georg4242/masterplatine_robosax2018/SC images/board.png

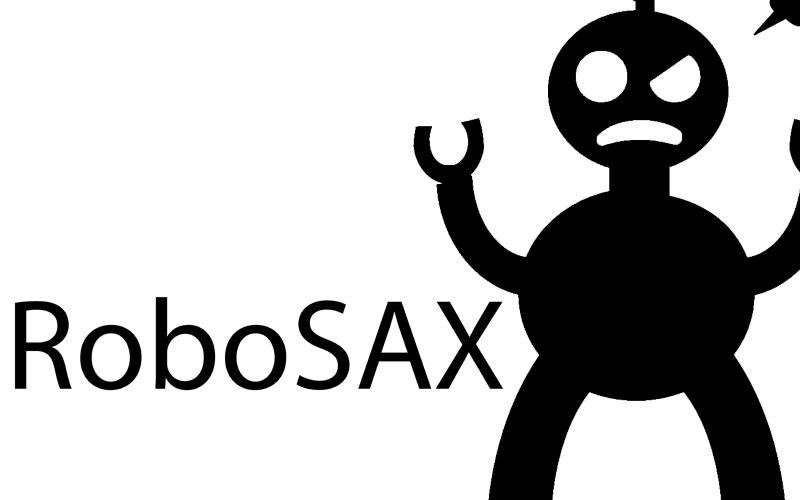
SC images/board.png
