georg4242/masterplatine_robosax2018/masterbox.kicad_pcb

## KiCad design masterbox.kicad_pcb (2018-01-08)

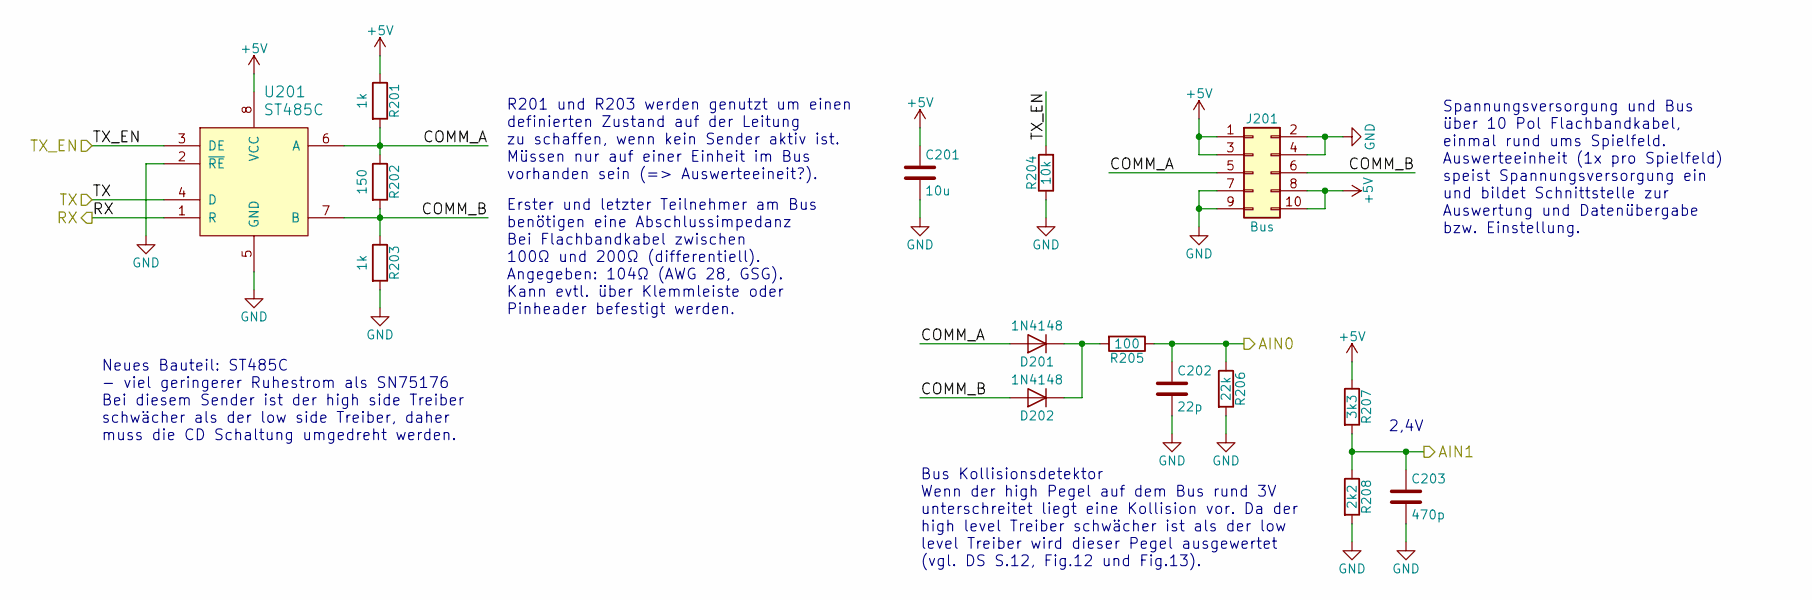
[picture p2: schematic Bus.sch]

Parts:
C201: 10u; C_0805
C202: 22p; C_0805
C203: 470p; C_0805
D201, D202: 1N4148; D_SOD-123
J201: Bus; Pin_Header_Straight_2x05
R201, R203: 1k; R_0805
R202: 150; R_Axial_DIN0207_L6.3mm_D2.5mm_P7.62mm_Horizontal
R204: 10k; R_0805
R205: 100; R_0805
R206: 22k; R_0805
R207: 3k3; R_0805
R208: 2k2; R_0805
U201: ST485C; SOIC-8_3.9x4.9mm_Pitch1.27mm

Connections:
+5V: C201.1, J201.1, J201.3, J201.8, J201.10, R201.1, R207.1, U201.8 (VCC); also elsewhere on the board
/Bus/AIN0: C202.1, R205.1, R206.1; also elsewhere on the board
/Bus/AIN1: C203.1, R207.2, R208.1; also elsewhere on the board
/Bus/COMM_A: D201.2 (A), J201.5, R201.2, R202.1, U201.6 (A)
/Bus/COMM_B: D202.2 (A), J201.6, R202.2, R203.1, U201.7 (B)
/Bus/RX: U201.1 (R); also elsewhere on the board
/Bus/TX: U201.4 (D); also elsewhere on the board
/Bus/TX_EN: R204.2, U201.3 (DE); also elsewhere on the board
GND: C201.2, C202.2, C203.2, J201.2, J201.4, J201.7, J201.9, R203.2, R204.1, R206.2, R208.2, U201.2 (~RE), U201.5 (GND); also elsewhere on the board
unnamed: D201.1 (K), D202.1 (K), R205.2

Notes on the sheet:
Bus Kollisionsdetektor Wenn der high Pegel auf dem Bus rund 3V unterschreitet liegt eine Kollision vor. Da der high level Treiber schwächer ist als der low level Treiber wird dieser Pegel ausgewertet (vgl. DS S.12, Fig.12 und Fig.13).
2,4V
Erster und letzter Teilnehmer am Bus benötigen eine Abschlussimpedanz Bei Flachbandkabel zwischen 100Ω und 200Ω (differentiell). Angegeben: 104Ω (AWG 28, GSG). Kann evtl. über Klemmleiste oder Pinheader befestigt werden.
R201 und R203 werden genutzt um einen definierten Zustand auf der Leitung zu schaffen, wenn kein Sender aktiv ist. Müssen nur auf einer Einheit im Bus vorhanden sein (=> Auswerteeineit?).
Neues Bauteil: ST485C - viel geringerer Ruhestrom als SN75176 Bei diesem Sender ist der high side Treiber schwächer als der low side Treiber, daher muss die CD Schaltung umgedreht werden.
Spannungsversorgung und Bus über 10 Pol Flachbandkabel, einmal rund ums Spielfeld. Auswerteeinheit (1x pro Spielfeld) speist Spannungsversorgung ein und bildet Schnittstelle zur Auswertung und Datenübergabe bzw. Einstellung.

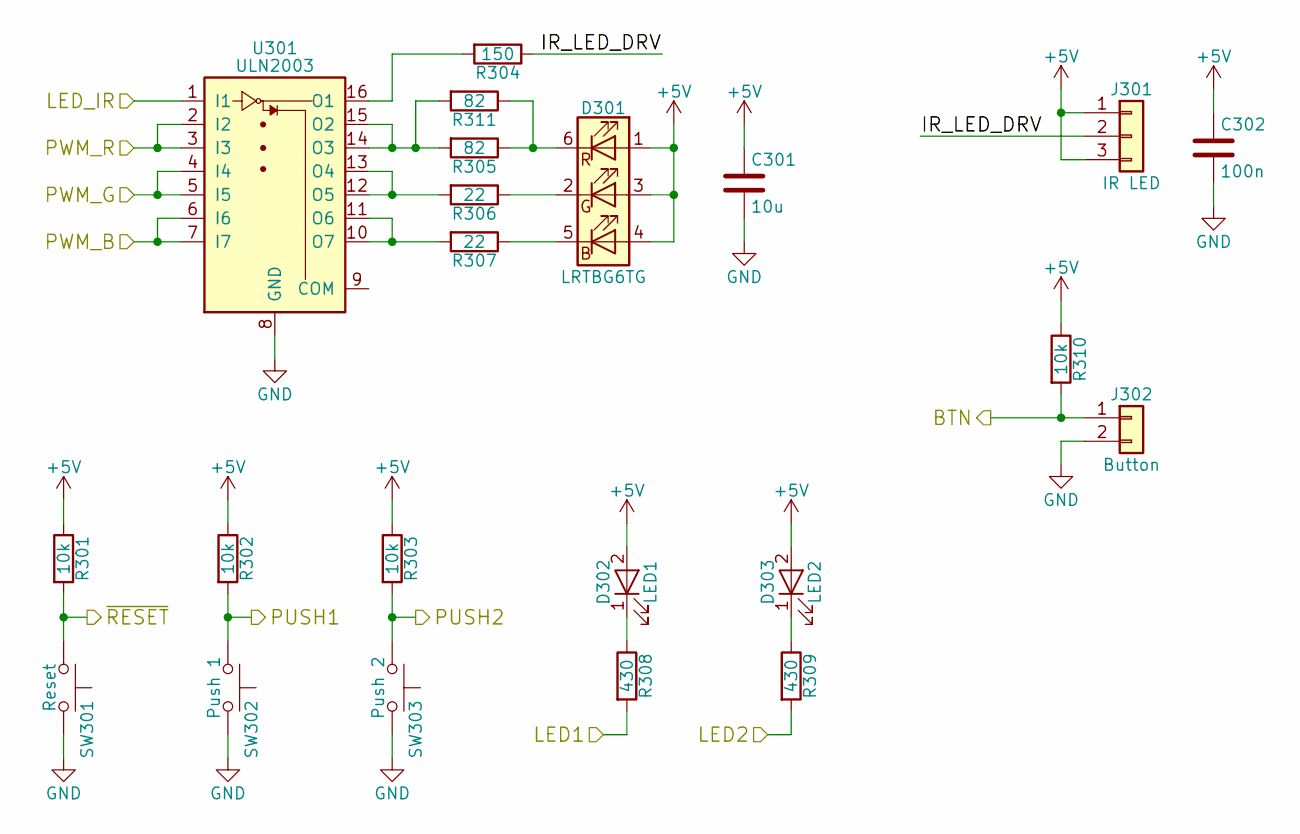
[picture p3: schematic Interface.sch]

Parts:
C301: 10u; C_0805
C302: 100n; C_0805
D301: LRTBG6TG; LED-6-BIG
D302: LED1; LED_0805
D303: LED2; LED_0805
J301: IR LED; Pin_Header_Straight_1x03
J302: Button; Pin_Header_Straight_1x02
R301, R302, R303, R310: 10k; R_0805
R304: 150; R_0805
R305, R311: 82; R_0805
R306, R307: 22; R_0805
R308, R309: 430; R_0805
SW301: Reset; SW_PUSH_6mm_h5mm
SW302: Push 1; SW_PUSH_6mm_h5mm
SW303: Push 2; SW_PUSH_6mm_h5mm
U301: ULN2003; SOIC-16_3.9x9.9mm_Pitch1.27mm

Connections:
+5V: C301.1, C302.1, D301.1 (RA), D301.3 (GA), D301.4 (BA), D302.2 (A), D303.2 (A), J301.1, J301.3, R301.1, R302.1, R303.1, R310.1; also elsewhere on the board
/Controller/BTN: J302.1, R310.2; also elsewhere on the board
/Controller/LED1: R308.2; also elsewhere on the board
/Controller/LED2: R309.2; also elsewhere on the board
/Controller/LED_IR: U301.1 (I1); also elsewhere on the board
/Controller/PUSH1: R302.2, SW302.1; also elsewhere on the board
/Controller/PUSH2: R303.2, SW303.1; also elsewhere on the board
/Controller/PWM_B: U301.6 (I6), U301.7 (I7); also elsewhere on the board
/Controller/PWM_G: U301.4 (I4), U301.5 (I5); also elsewhere on the board
/Controller/PWM_R: U301.2 (I2), U301.3 (I3); also elsewhere on the board
/Controller/~RESET: R301.2, SW301.1; also elsewhere on the board
/Interface/IR_LED_DRV: J301.2, R304.1
GND: C301.2, C302.2, J302.2, SW301.2, SW302.2, SW303.2, U301.8 (GND); also elsewhere on the board
unnamed: D301.2 (GK), R306.1
unnamed: D301.5 (BK), R307.1
unnamed: D301.6 (RK), R305.1, R311.1
unnamed: D302.1 (K), R308.1
unnamed: D303.1 (K), R309.1
unnamed: R304.2, U301.16 (O1)
unnamed: R305.2, R311.2, U301.14 (O3), U301.15 (O2)
unnamed: R306.2, U301.12 (O5), U301.13 (O4)
unnamed: R307.2, U301.10 (O7), U301.11 (O6)

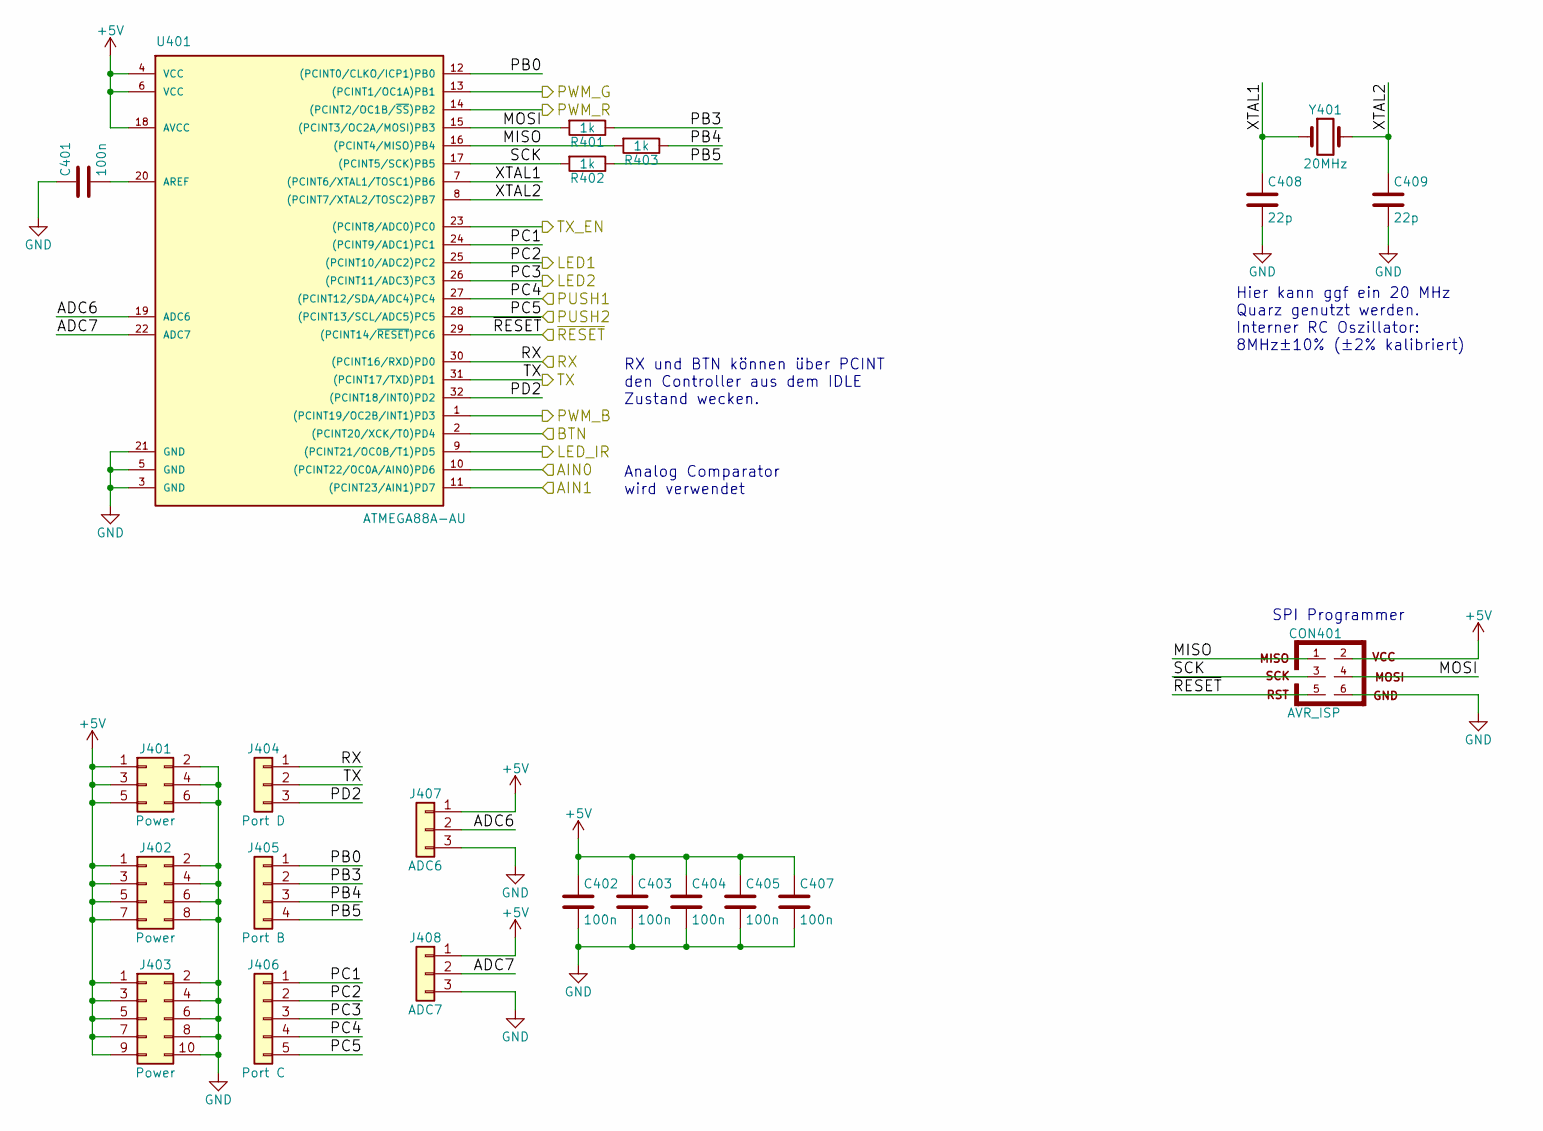
[picture p4: schematic Controller.sch]

Parts:
C401, C402, C403, C404, C405, C407: 100n; C_0805
C408, C409: 22p; C_0805
CON401: AVR_ISP; Pin_Header_Straight_2x03
J401: Power; Socket_Strip_Straight_2x03
J402: Power; Socket_Strip_Straight_2x04
J403: Power; Socket_Strip_Straight_2x05
J404: Port D; Socket_Strip_Straight_1x03
J405: Port B; Socket_Strip_Straight_1x04
J406: Port C; Socket_Strip_Straight_1x05
J407: ADC6; Socket_Strip_Straight_1x03
J408: ADC7; Socket_Strip_Straight_1x03
R401, R402, R403: 1k; R_0805
U401: ATMEGA88A-AU; TQFP-32_7x7mm_Pitch0.8mm
Y401: 20MHz; Crystal_HC49-SD_SMD

Connections:
+5V: C402.1, C403.1, C404.1, C405.1, C407.1, CON401.2, J401.1, J401.3, J401.5, J402.1, J402.3, J402.5, J402.7, J403.1, J403.3, J403.5, J403.7, J403.9, J407.1, J408.1, U401.4 (VCC), U401.6 (VCC), U401.18 (AVCC); also elsewhere on the board
/Bus/AIN0: U401.10 ((PCINT22/OC0A/AIN0)PD6); also elsewhere on the board
/Bus/AIN1: U401.11 ((PCINT23/AIN1)PD7); also elsewhere on the board
/Bus/RX: J404.1, U401.30 ((PCINT16/RXD)PD0); also elsewhere on the board
/Bus/TX: J404.2, U401.31 ((PCINT17/TXD)PD1); also elsewhere on the board
/Bus/TX_EN: U401.23 ((PCINT8/ADC0)PC0); also elsewhere on the board
/Controller/ADC6: J407.2, U401.19 (ADC6)
/Controller/ADC7: J408.2, U401.22 (ADC7)
/Controller/BTN: U401.2 ((PCINT20/XCK/T0)PD4); also elsewhere on the board
/Controller/LED1: J406.2, U401.25 ((PCINT10/ADC2)PC2); also elsewhere on the board
/Controller/LED2: J406.3, U401.26 ((PCINT11/ADC3)PC3); also elsewhere on the board
/Controller/LED_IR: U401.9 ((PCINT21/OC0B/T1)PD5); also elsewhere on the board
/Controller/MISO: CON401.1, R403.2, U401.16 ((PCINT4/MISO)PB4)
/Controller/MOSI: CON401.4, R401.2, U401.15 ((PCINT3/OC2A/MOSI)PB3)
/Controller/PB0: J405.1, U401.12 ((PCINT0/CLKO/ICP1)PB0)
/Controller/PB3: J405.2, R401.1
/Controller/PB4: J405.3, R403.1
/Controller/PB5: J405.4, R402.1
/Controller/PC1: J406.1, U401.24 ((PCINT9/ADC1)PC1)
/Controller/PD2: J404.3, U401.32 ((PCINT18/INT0)PD2)
/Controller/PUSH1: J406.4, U401.27 ((PCINT12/SDA/ADC4)PC4); also elsewhere on the board
/Controller/PUSH2: J406.5, U401.28 ((PCINT13/SCL/ADC5)PC5); also elsewhere on the board
/Controller/PWM_B: U401.1 ((PCINT19/OC2B/INT1)PD3); also elsewhere on the board
/Controller/PWM_G: U401.13 ((PCINT1/OC1A)PB1); also elsewhere on the board
/Controller/PWM_R: U401.14 ((PCINT2/OC1B/~SS~)PB2); also elsewhere on the board
/Controller/SCK: CON401.3, R402.2, U401.17 ((PCINT5/SCK)PB5)
/Controller/XTAL1: C408.1, U401.7 ((PCINT6/XTAL1/TOSC1)PB6), Y401.1
/Controller/XTAL2: C409.1, U401.8 ((PCINT7/XTAL2/TOSC2)PB7), Y401.2
/Controller/~RESET: CON401.5, U401.29 ((PCINT14/~RESET~)PC6); also elsewhere on the board
GND: C401.1, C402.2, C403.2, C404.2, C405.2, C407.2, C408.2, C409.2, CON401.6, J401.2, J401.4, J401.6, J402.2, J402.4, J402.6, J402.8, J403.2, J403.4, J403.6, J403.8, J403.10, J407.3, J408.3, U401.3 (GND), U401.5 (GND), U401.21 (GND); also elsewhere on the board
unnamed: C401.2, U401.20 (AREF)

Notes on the sheet:
Hier kann ggf ein 20 MHz Quarz genutzt werden. Interner RC Oszillator: 8MHz±10% (±2% kalibriert)
RX und BTN können über PCINT den Controller aus dem IDLE Zustand wecken.
SPI Programmer
Analog Comparator wird verwendet

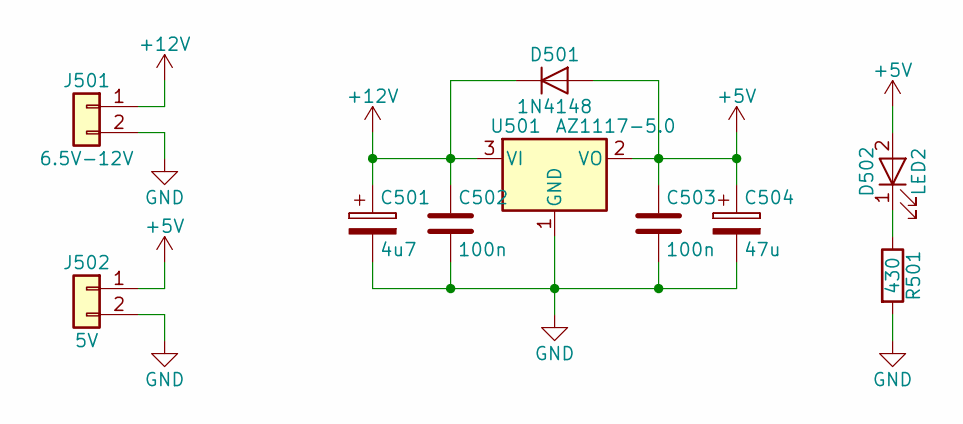
[picture p5: schematic Supply.sch]

Parts:
C501: 4u7; CP_Radial_D5.0mm_P2.00mm
C502, C503: 100n; C_0805
C504: 47u; CP_Radial_D6.3mm_P2.50mm
D501: 1N4148; D_SOD-123
D502: LED2; LED_0805
J501: 6.5V-12V; TerminalBlock_Pheonix_MKDS1.5-2pol
J502: 5V; TerminalBlock_Pheonix_MKDS1.5-2pol
R501: 430; R_0805
U501: AZ1117-5.0; SOT-223-3Lead_TabPin2

Connections:
+5V: C503.1, C504.1, D501.2 (A), D502.2 (A), J502.1, U501.2 (VO); also elsewhere on the board
+12V: C501.1, C502.1, D501.1 (K), J501.1, U501.3 (VI)
GND: C501.2, C502.2, C503.2, C504.2, J501.2, J502.2, R501.2, U501.1 (GND); also elsewhere on the board
unnamed: D502.1 (K), R501.1

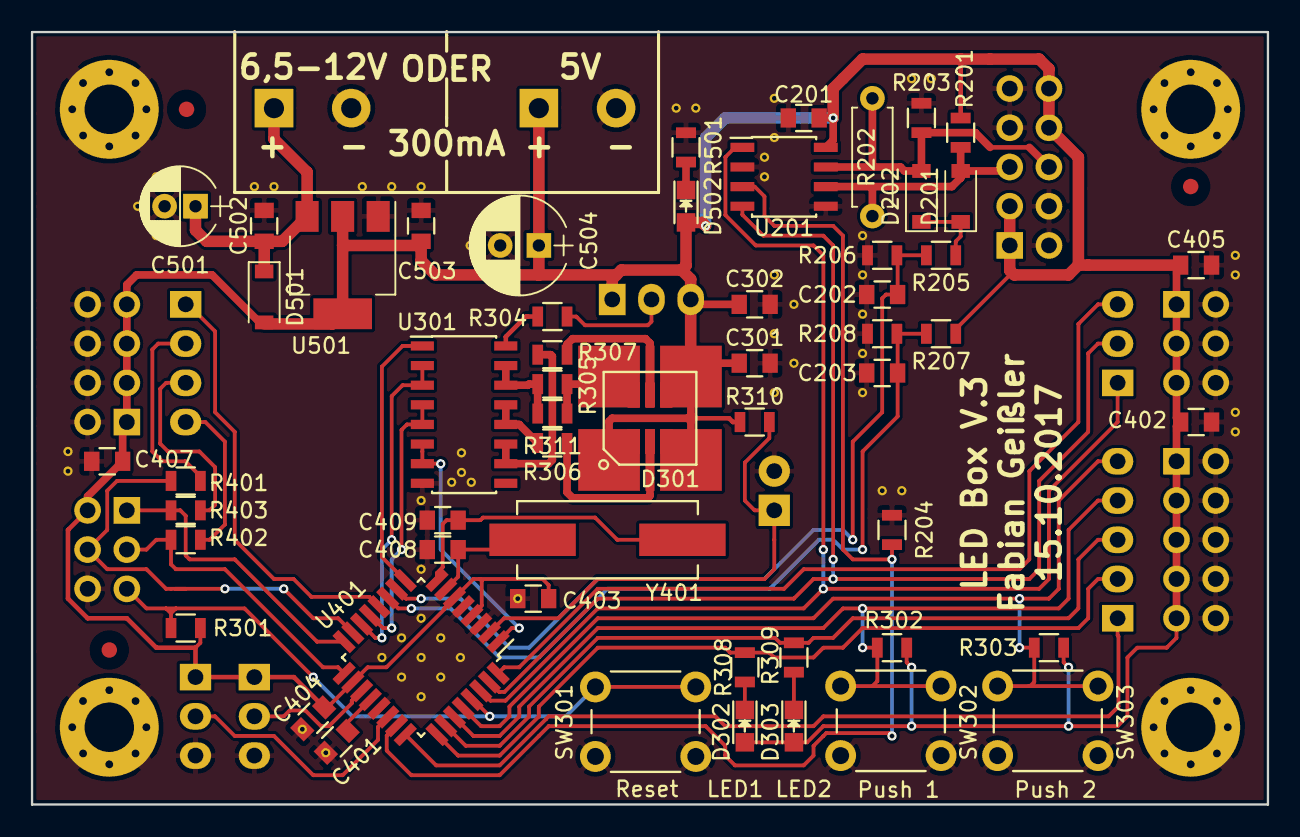
[picture p6: board masterbox.kicad_pcb from above]

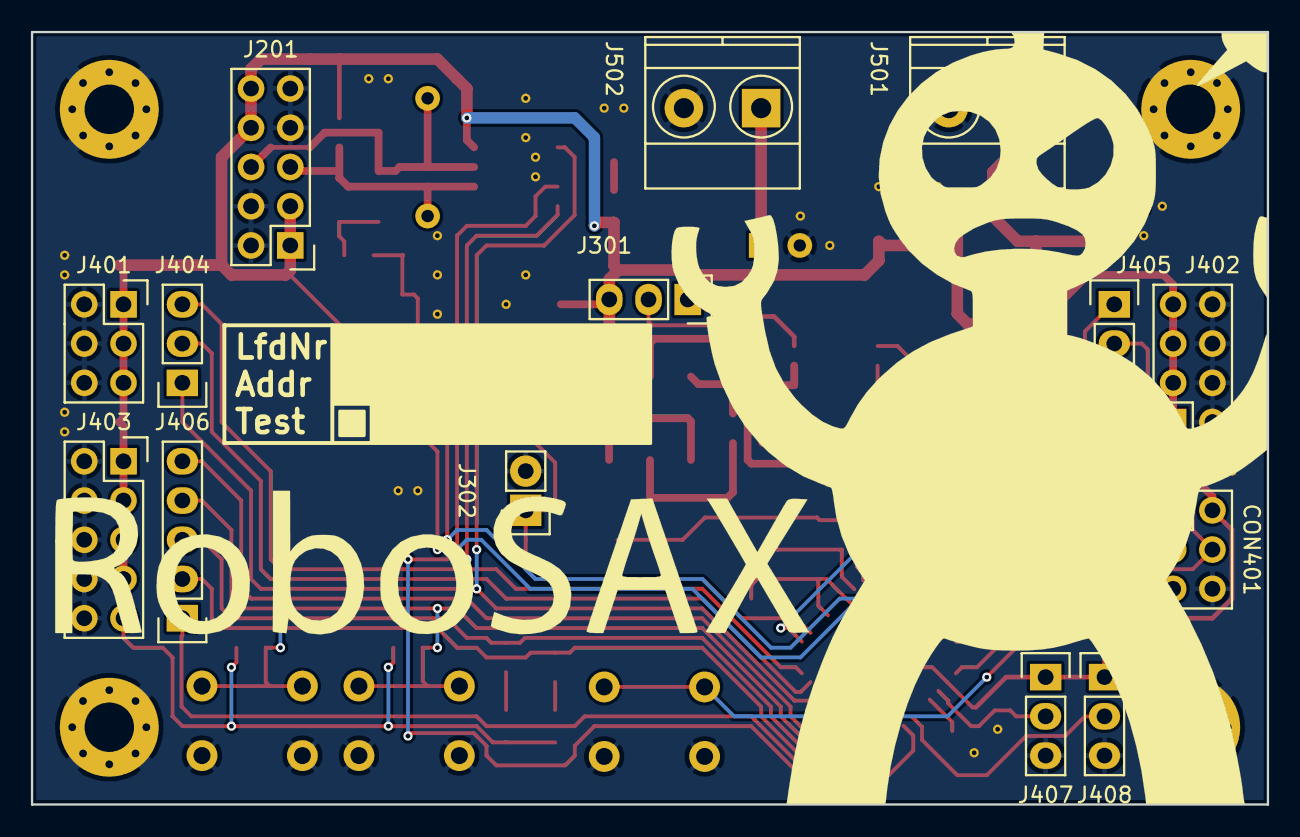
[picture p7: board masterbox.kicad_pcb from below]

Board: 2 copper layers, 80.0 x 50.0 mm, 69 parts (14 on the bottom side), 46 nets.
