georg4242/masterplatine_robosax2018/(commit log)

2018-01-08 Fabian original status.
    [Bus.sch, Controller.sch, Interface.sch, Supply.sch, masterbox.kicad_pcb, masterbox.sch]
2018-01-08 Little interface changing.
    [Bus.sch, Controller.sch, Interface.sch, Supply.sch, masterbox.sch]
2018-01-08 ATmega2560 inserted
    [Bus.sch, Controller.sch, Interface.sch, masterbox.sch]
